tepmach2/Tepmachcha_mod/Production/IMG_0365.JPG

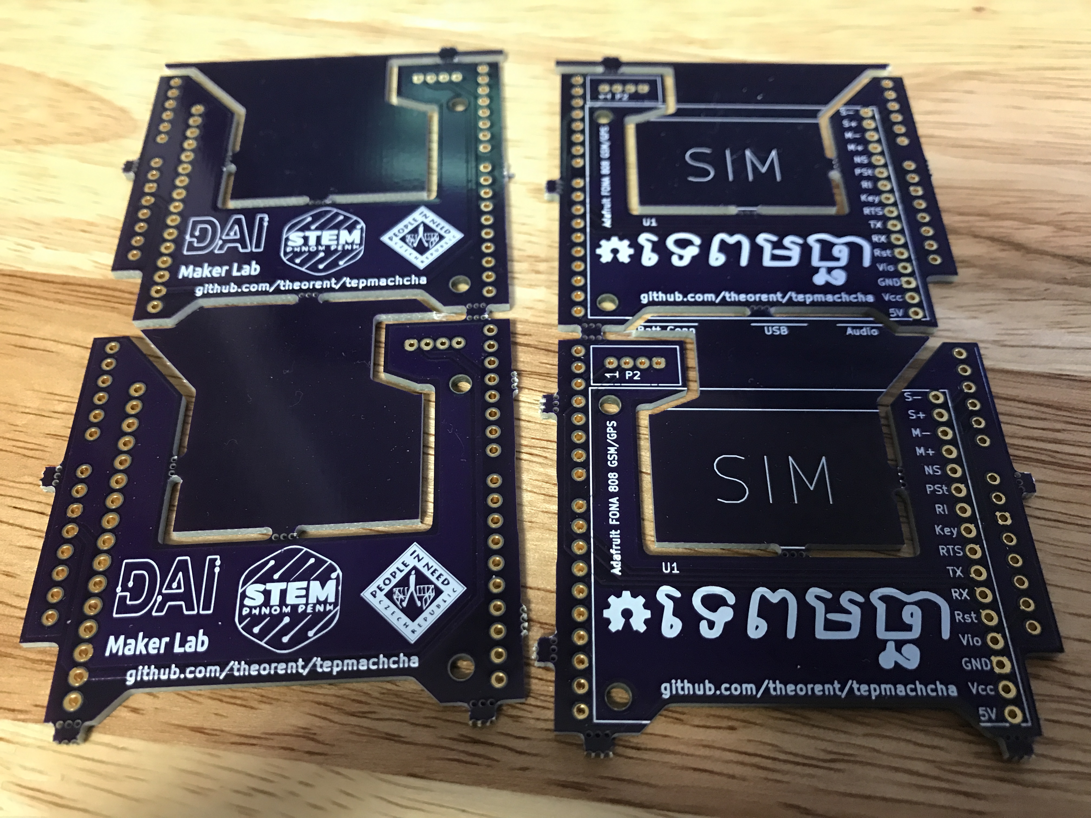
Production/IMG_0365.JPG
