tepmach2/Tepmachcha_mod/Production/IMG_0363.JPG

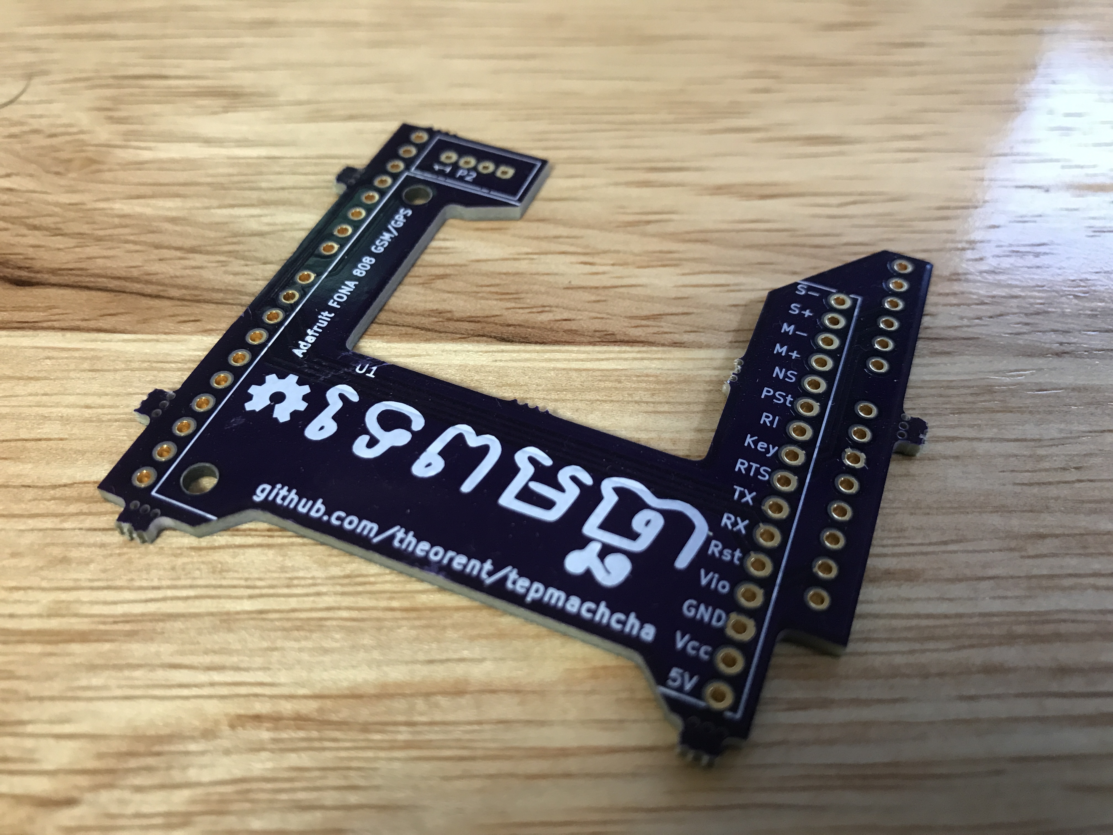
Production/IMG_0363.JPG
