tepmach2/Tepmachcha_mod/README.md

# Tepmachcha_mod

Reworking of original Tepmachcha board for improved stability and mechanical access to seeed stalker board below.
