tepmach2/Tepmachcha_mod/Production/bottom.png

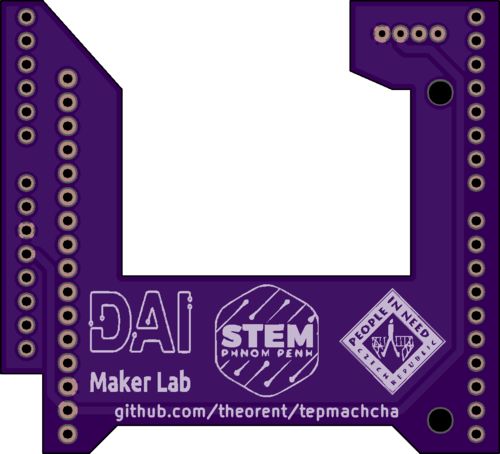
Production/bottom.png
