tepmach2/Tepmachcha_mod/Production/IMG_0364.JPG

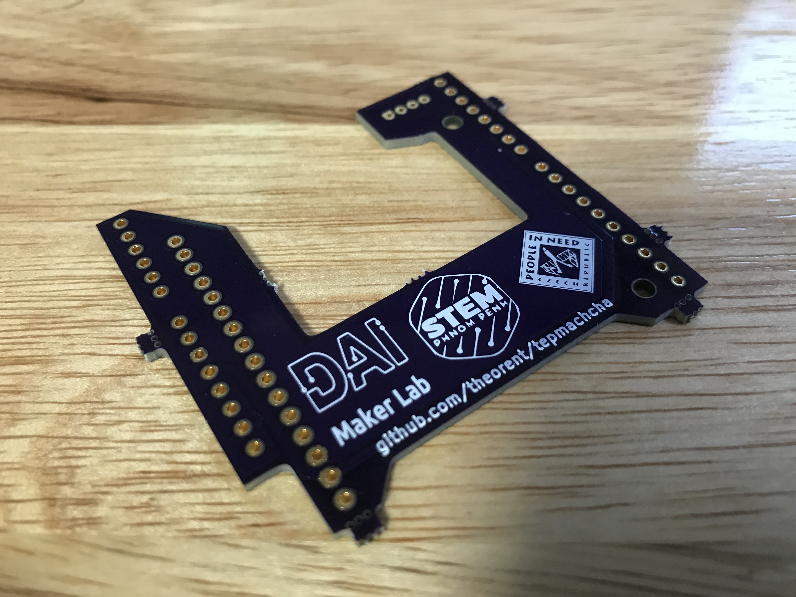
Production/IMG_0364.JPG
