tepmach2/Tepmachcha_mod/Production/top.png

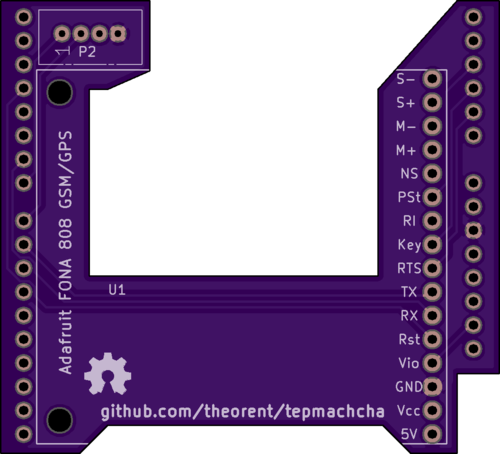
Production/top.png
