tepmach2/Tepmachcha_mod/tep_mod.kicad_pcb

## KiCad design tep_mod.kicad_pcb (2017-04-28)

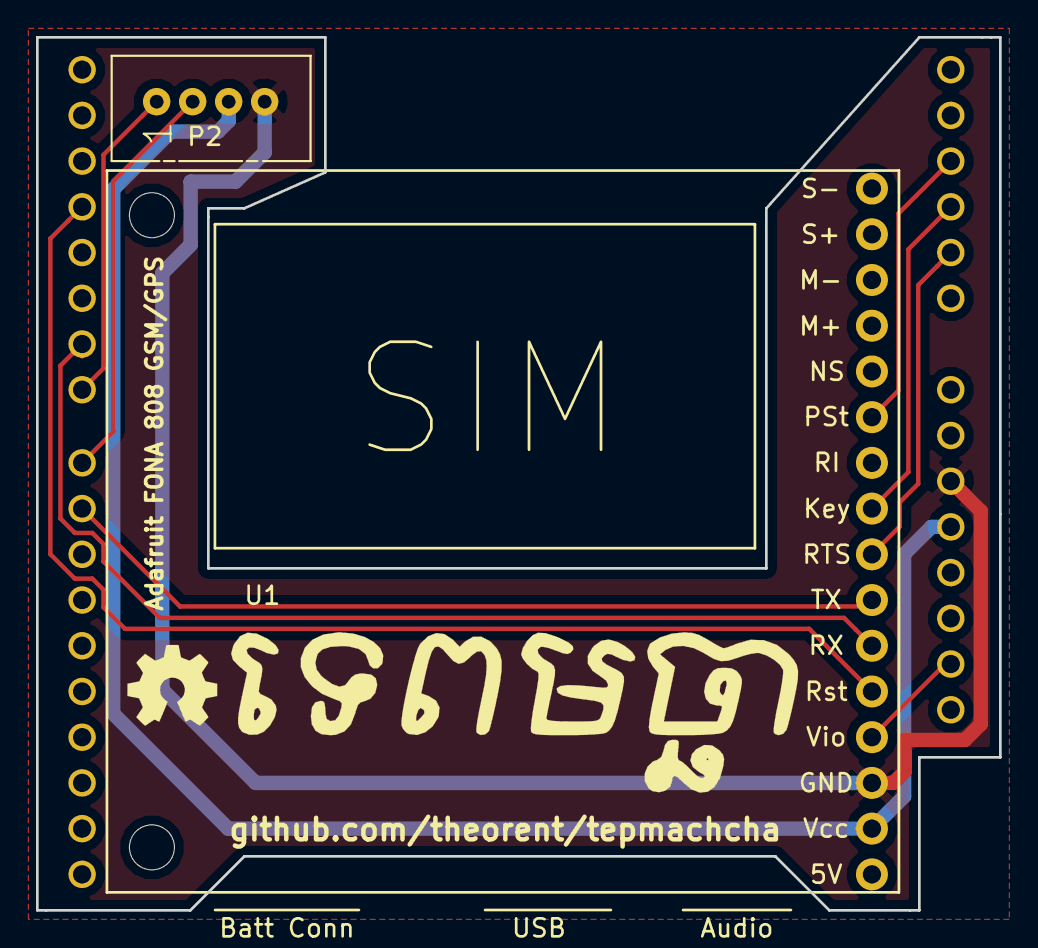
[picture p6: board tep_mod.kicad_pcb from above]

Board: 2 copper layers, 53.5 x 48.5 mm, 4 parts (0 on the bottom side), 11 nets.

Parts:
LOGO_OSHW_silkscreen_5mm: val**; LOGO_OSHW_silkscreen_5mm
P2: CONN_01X04; Grove_1x04
SHIELD1: ARDUINO_SHIELD
U1: FONA_808; Adafruit_FONA_808_Theorent

Connections:
GND: P2.4, SHIELD1.GND1, U1.3
unnamed: P2.1, SHIELD1.7
unnamed: P2.2, SHIELD1.8
unnamed: SHIELD1.3, U1.5
unnamed: SHIELD1.6, U1.6
unnamed: SHIELD1.9, U1.7
unnamed: SHIELD1.AD1, U1.8
unnamed: SHIELD1.AD2, U1.9
unnamed: SHIELD1.AD3, U1.11
unnamed: SHIELD1.IO_R, U1.4
VCC: P2.3, SHIELD1.5V, U1.2
