tepmach2/Tepmachcha_mod/(commit log)

2017-04-07 Initial commit
    Cicada project elements copied over
    [tep_mod.kicad_pcb, tep_mod.sch]
2017-04-07 Pin assignment changes
    Freeing SPI bus for SD card use. Adding ICSP breakout on top. RTS pin
    assigned. Other small changes and tidying up.
    [tep_mod.sch]
2017-04-10 v 0.1 board files
    [tep_mod-B.Cu.gbl, tep_mod-B.Mask.gbs, tep_mod-B.SilkS.gbo, tep_mod-Edge.Cuts.gm1, tep_mod-F.Cu.gtl, tep_mod-F.Mask.gts, tep_mod-F.SilkS.gto, tep_mod-NPTH.drl]
2017-04-27 Add logos in new graphics library
    [tep_mod-B.Cu.gbl, tep_mod-B.Mask.gbs, tep_mod-B.SilkS.gbo, tep_mod-Edge.Cuts.gm1, tep_mod-F.Cu.gtl, tep_mod-F.Mask.gts, tep_mod-F.SilkS.gto, tep_mod-NPTH.drl]
2017-04-28 Added Khmer script
    Added Tepmachcha to board in Khmer OS script. Output directory change
    (but it’s still local sorry)
    [tep_mod.kicad_pcb]
2017-05-21 Pictures of finished boards
